ILikeMice/spymic/JOURNAL.md

# FYI, the time in brackets shows how time much i (roughly) spent on that session

## 06.08.26
### Initial research (~3h)

So, new project yaay, for this project i wanna make some sort of device i could stick onto walls (walls in question being doors/windows too maybe?) and listen to whatevers going on on the other side <br>
Disclaimer:: im making this thing for https://ispy.hackclub.com fyi, incase ts looks weirder than my other projects :p <br>
Overall this was inspired by some laser mic videos i saw online a couple years ago and me trying to listen to some oral test in a classroom before me through my phone, also a couple years ago!! (i would never now though)

I never really worked with mics and such, and defo not with laser mics or anything, so i was completely clueless as where to even start... <br>
My first thought was to replicate the same thing the people have done in the laser mic videos on youtube, mainly by shining a laser onto a window and it reflecting onto a solar cell, whereas the vibrations of the deflected laser would be picked up due to the laser not being completely on the solar cell and therefore the output would change in intensity when the surface vibrated. <br>
Some setups i looked into looked like this:
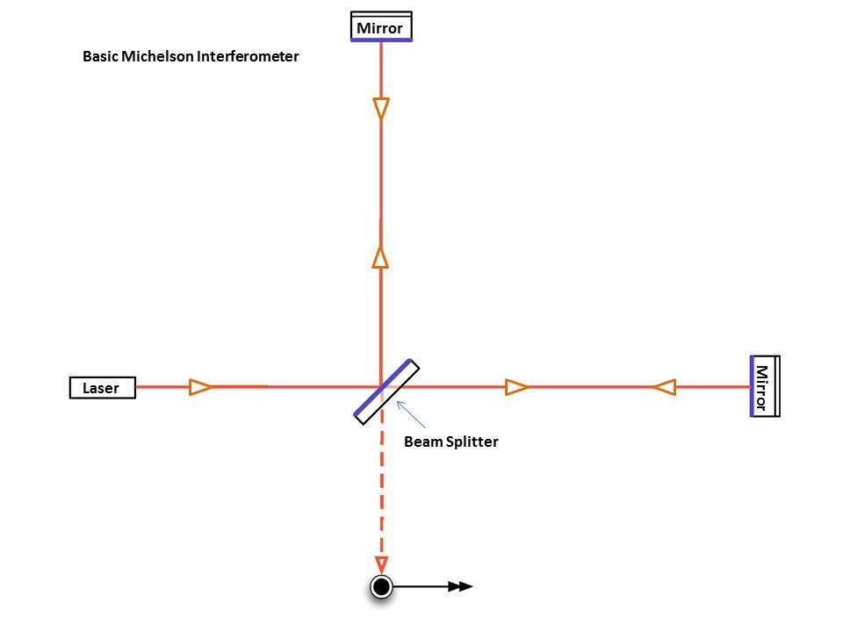
[picture p1: images/image-1.png]

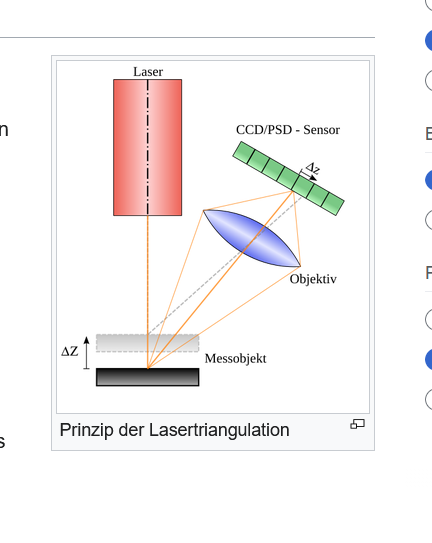
[picture p2: images/image-2.png]


Whereas i liked the first approach more tbh, but the 2nd one is cool too. The only problem(s) with this are though that <br>
1. if i attached the laser and the probe mirror as per the first approach (theres one control and one probe mirror, the probe mirror is on the vibrating surface) to the same surface, from the lasers POV there wouldnt be any sound or vibrations, so it wouldnt work at all.
2. the 2nd approach wouldnt really work either due to point 1. and the fact that im trying to attach this to a door, which MIGHT not be as reflective as a mirror/window, so were not getting any response on that either...

After the cool laser idea has been shattered, i decided to look into some other types of mics and found out about contact mics! They seem to be pretty cheap, and, after checking out some questionable vids about guys building them, i liked their quality enough and decided to use them!
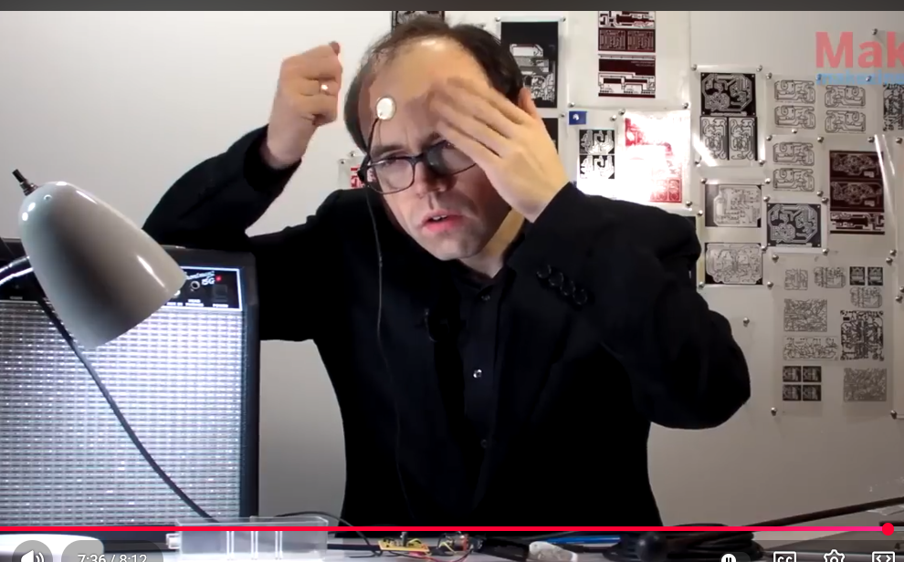
[picture p3: images/image-3.png]

shoutout this cool guy from 14 years ago on [youtube](https://www.youtube.com/watch?v=aOJuCYgmPPE) for demonstrating all that

Also started doing some research on components to use in the project, and got some example schematics to maybe use later on! Turns out piezo discs are real cheap, so i can make lots of these is the pcb and components are also cheap!! (for education purposes only)

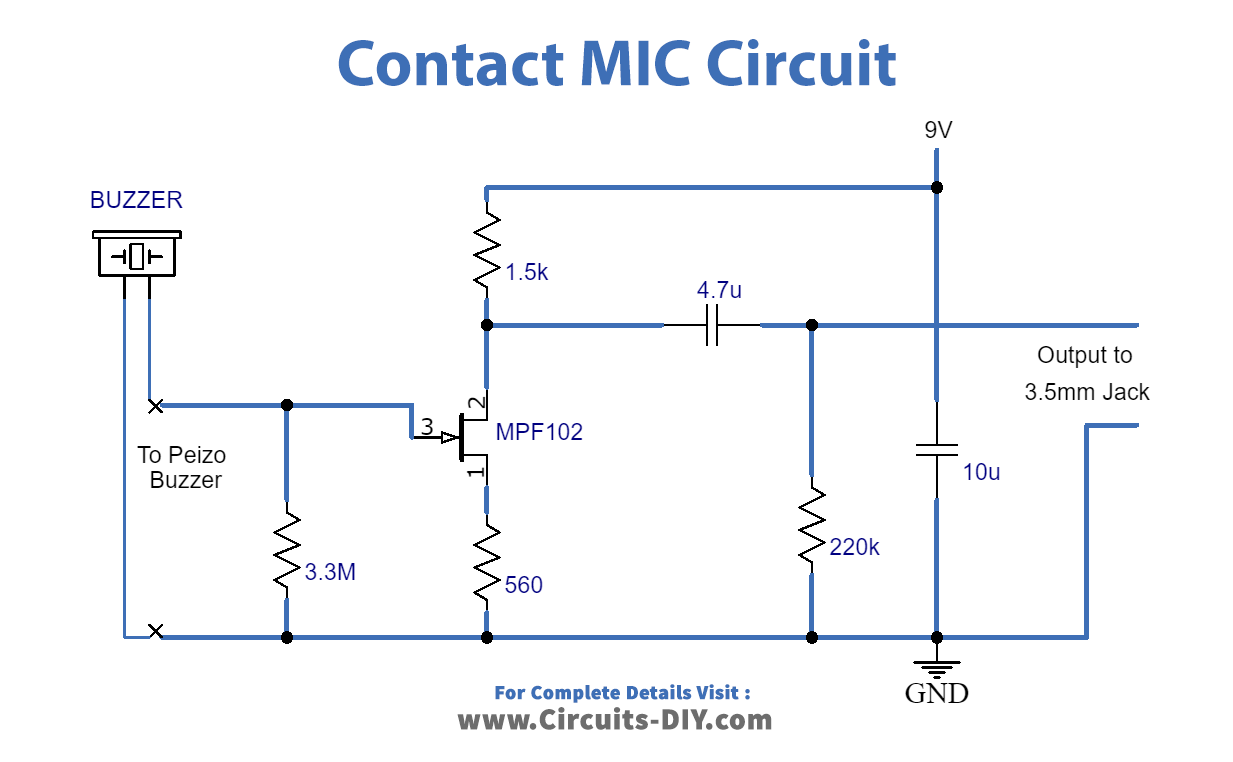
[picture p4: images/image.png]


Thats all for now, ive got some more features in mind that id love to add, but its about midnight here and id probably work on this tmrw!

## 08.08.26
### More research (~3.5h)

As the title suggests, i did some more research on this stuff. Mainly messed around in falstad though with the circuit but there was a fair share of researching done!!
<br>
So, at first i tried copying the circuit above into falstad, and after searching it up, i could replace the mic with an AC source in series with a capacitor with the capacitance of the mic.

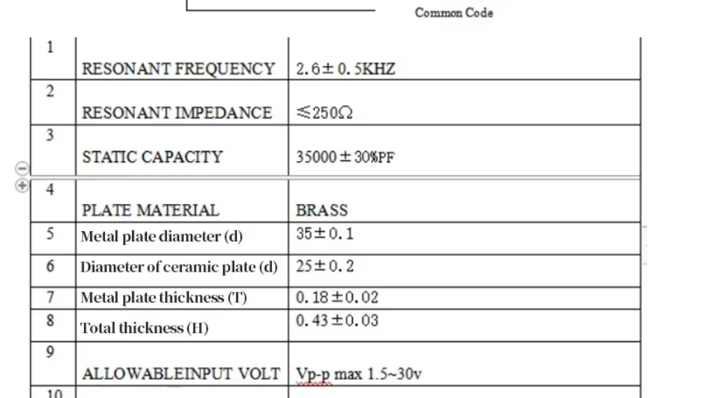
[picture p5: images/image-5.png]

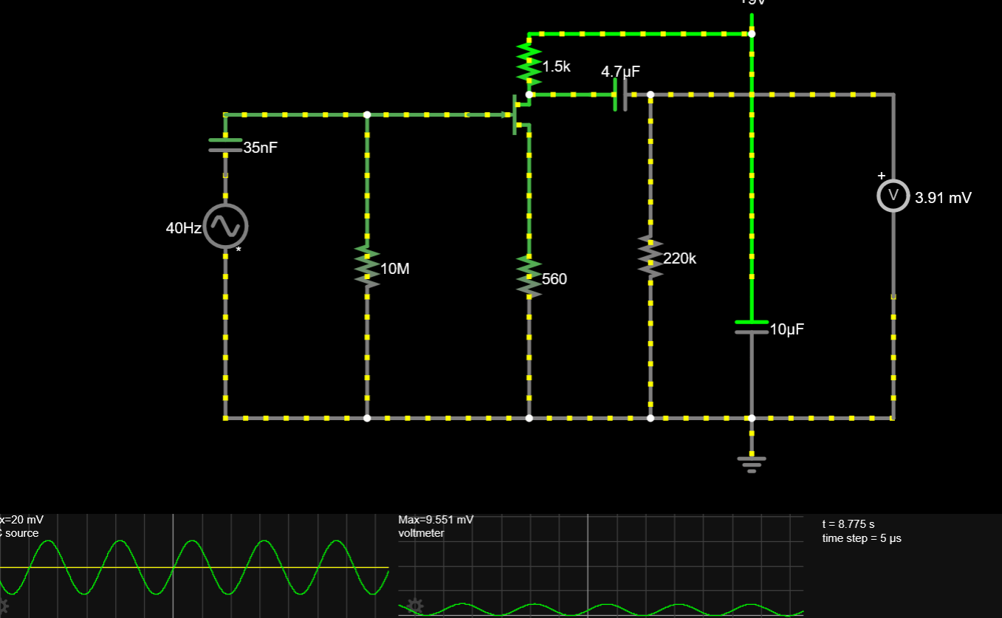
[picture p6: images/image-6.png]


<br>

For some reason, even after messing around with it for a while, that didnt work at all, so after looking some more stuff up and trying different configurations i just gave up, until i discovered opamps exist!! That seemed to be way easier and i had a circuit working almost directly!

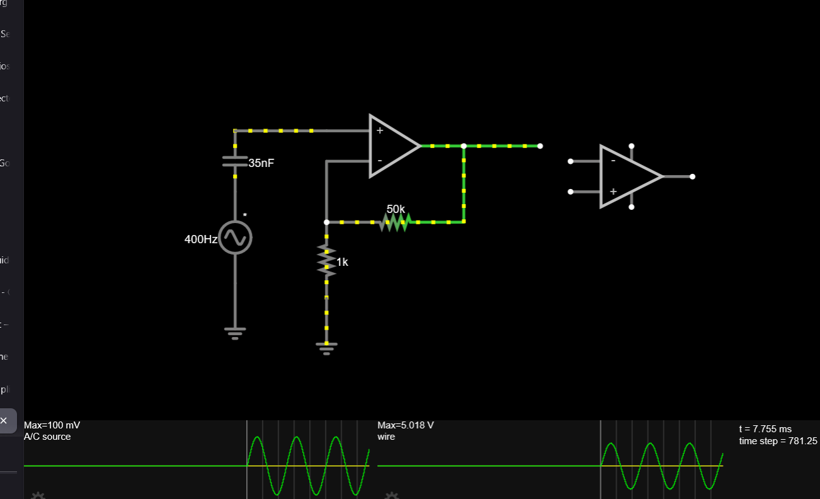
[picture p7: images/image-7.png]


<br> 
that was until i tried using a real opamp, which for some reason fucked everything up and just flatlined..

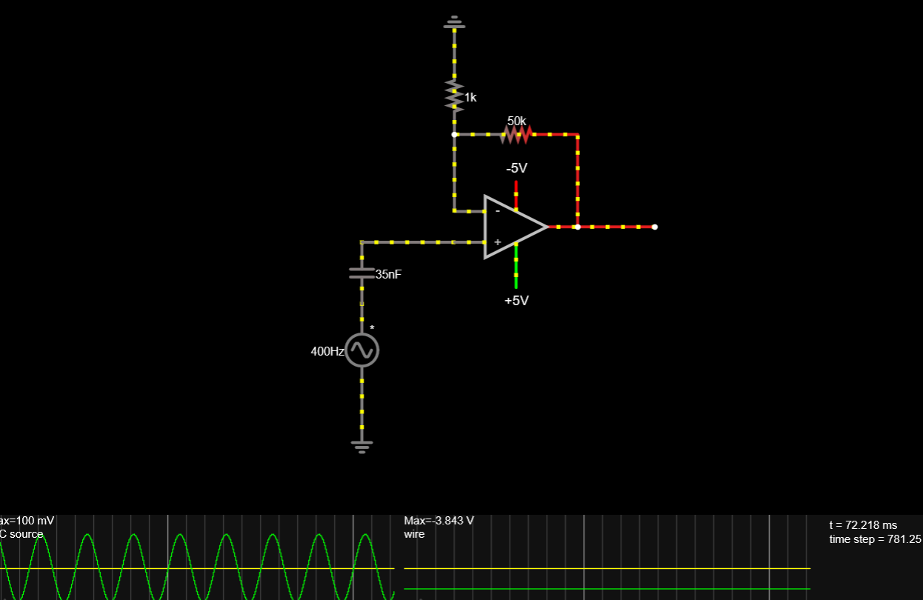
[picture p8: images/image-8.png]

<br>

the fix for the flatline was me being dumb and having the polarity of the opamp power reversed, and turns out i needed a pulldown resistor for the wave maximum to not go down slowly after that, for some reason i cant be bothered to understand, im just glad this shit finally works

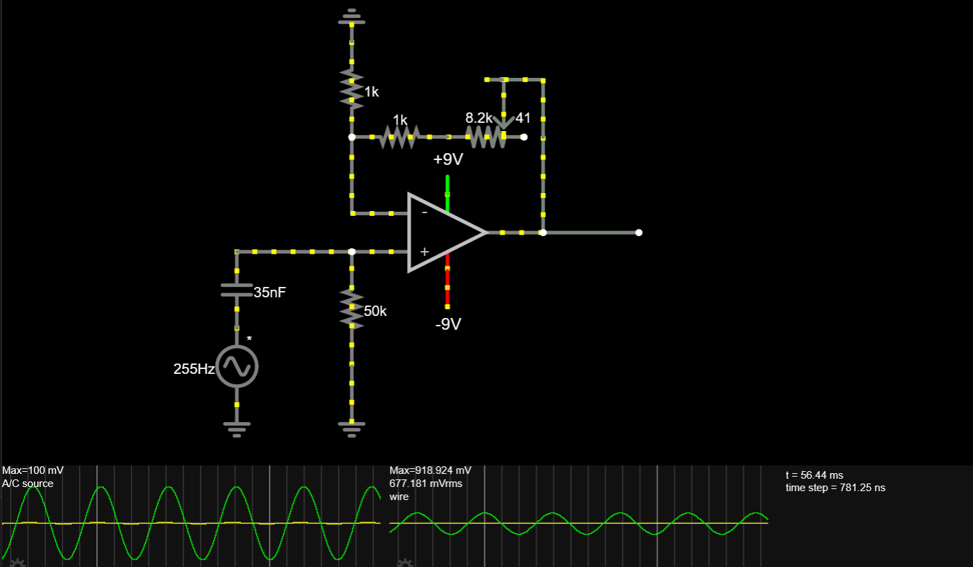
[picture p9: images/image-9.png]


Also started doing the schematic in kicad, but that took waayy longer than i thought, since i cant just feed 9v into the average opamp IC, so i had to look into buck converters after first finding an IC thats good enough and understanding what all the specs are

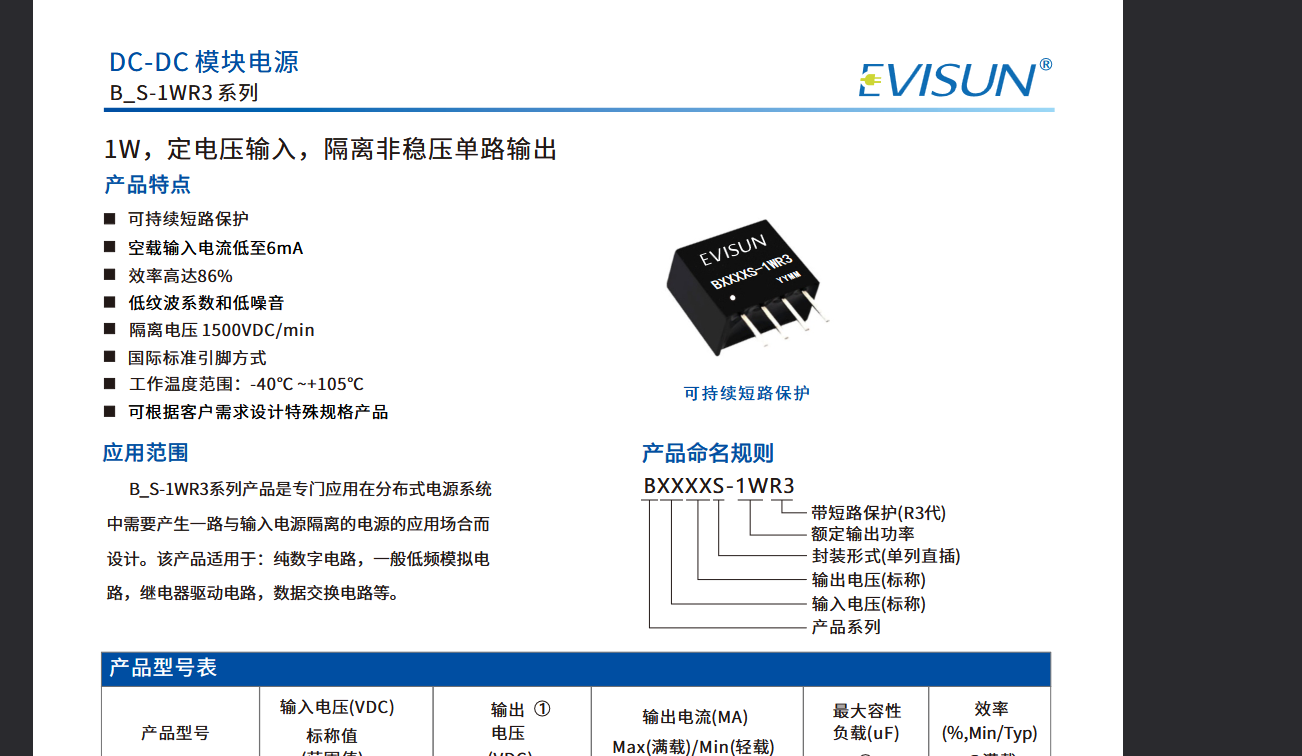
[picture p10: images/image-10.png]


didnt help much either that the datasheets for buck converters are ALL in chineese

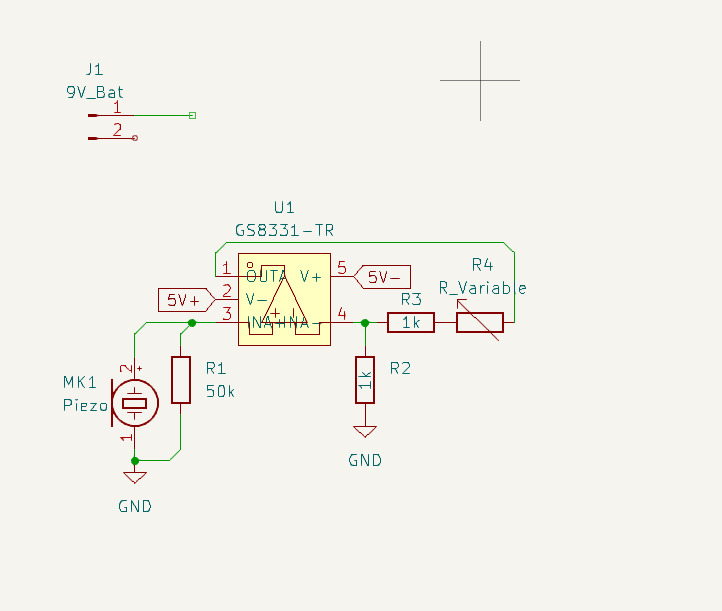
[picture p11: images/image-11.png]


## 09.08.26
### Component search (~2h)

So, now ive got the main amp thingy ready, but the only problem is that i cant just feed 9V into it, due to the opamps maximum ratings. I looked for a while on lcsc for some bigger opamps, but couldnt find one thatd fit me.. the 2nd option would be to have a stepdown with/without a LDO, i already started looking for buck converters yesterday, but the only one i found had a max power of just 1W, and i wasnt really sure if thatd be enough for me, besides, its output was 5v afaik, and to convert those to a clean 5V with an LDO i need a value higher than 5v, for example 6 or 6.5v

<br>

Only problem with other stepdowns is that they have only one, positive output, which also kinda fucks with the whole opamp circuit. I tried replacing the ground with a certain voltage so the wave would be somewhat offset, but i could only achieve that with an exact voltage of 3v, above which the wave would cut off on the top.

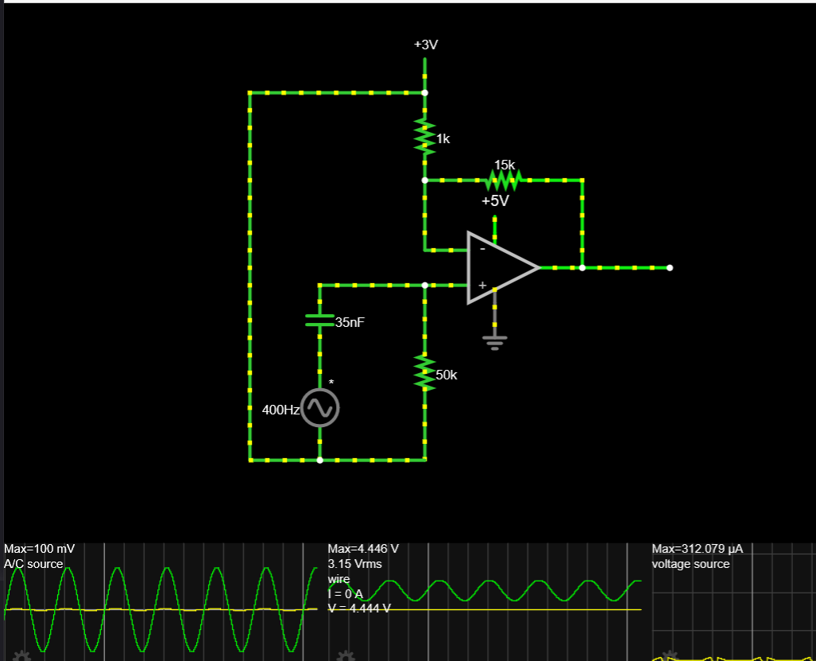
[picture p12: images/image-12.png]

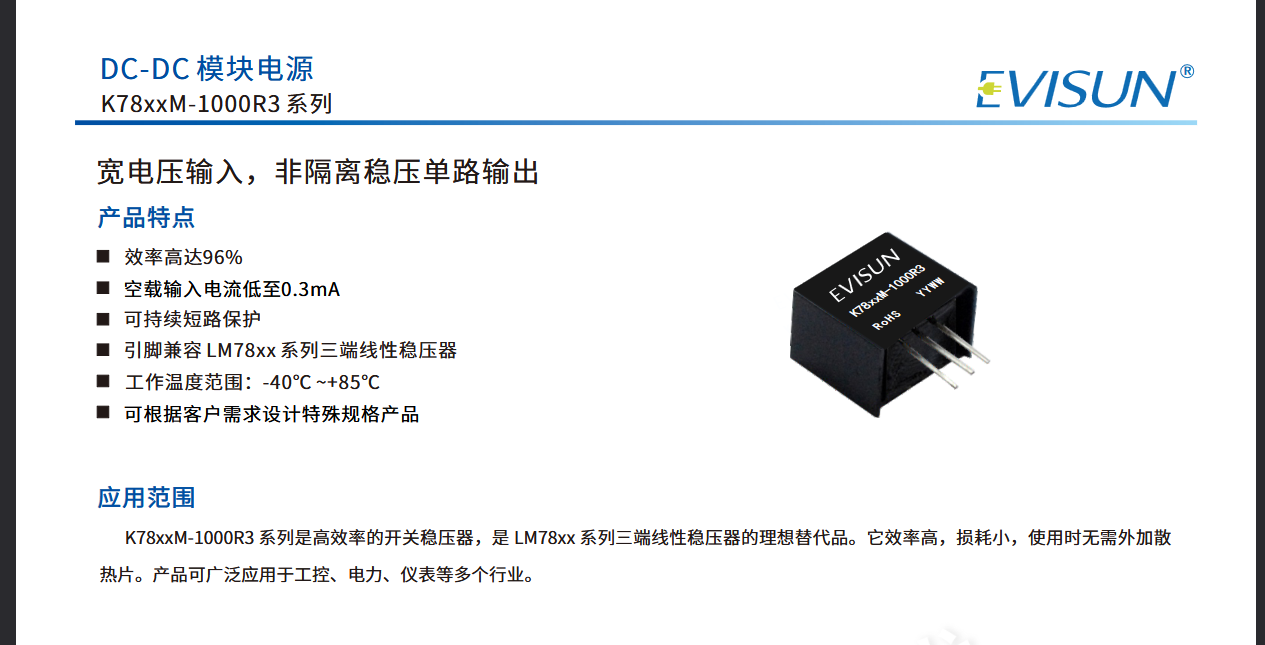
[picture p13: images/image-14.png]


since this approach sucks, i just looked into how i can invert a signal or something, but didnt really find a nice enough solution... while writing this journal though i stumbled upon the perfect buck converter, even though this one drops the voltage to 5v, but idgaf at this point and one single 1$ IC can give me both the negative and positive output i needed

### Power stuffs (~2h)

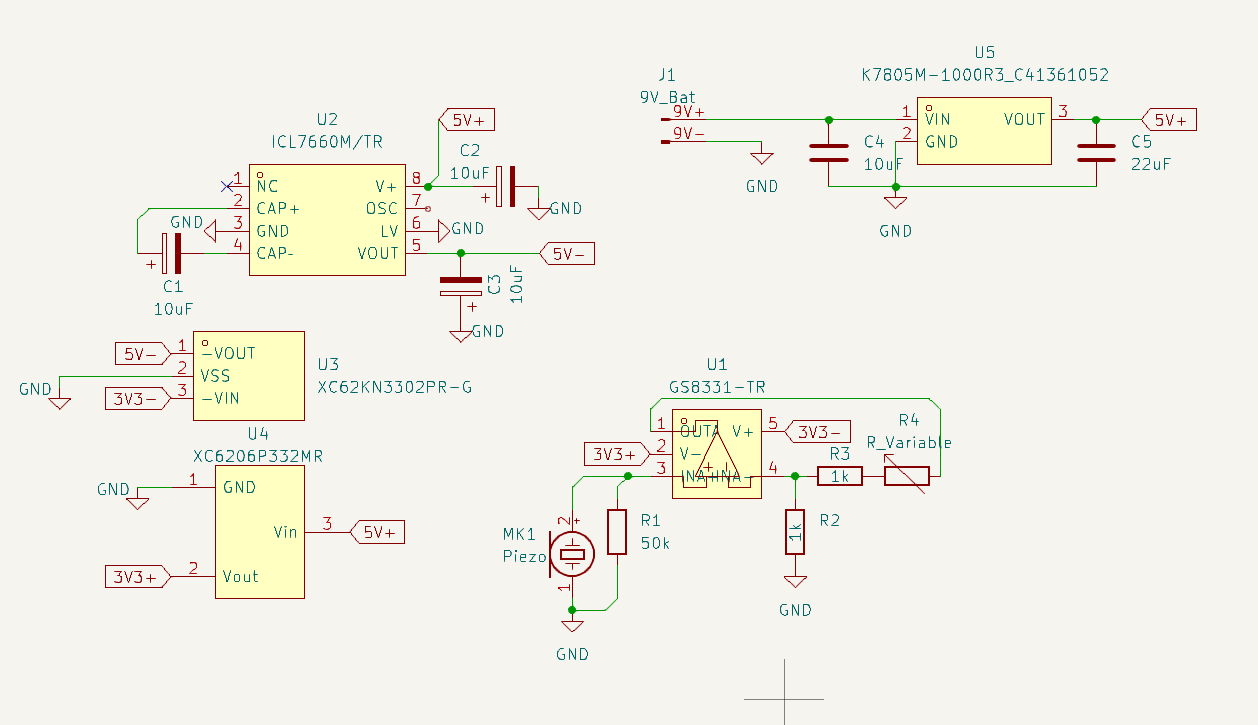
[picture p14: images/image-16.png]

So, forget whatever i said about the buck converter last journal, that IC could indeed not give both positive and negative outputs, sadly :/ after digging some more, i just decided to get an inverter for the negative signal. Didnt really wanna do this, but im hoping ill get a decently clean signal from both LDOs. Other than that, i think i should be almost fully done with the pcb part of this! just gotta add a potentiometer and headphone port, or add different output methods if i feel like it!!

## 15.08.26
### More power stuffs and hopefully finishing the PCB now (~1h)
Back again, been procrastinating this for a whiiiile because of some other stuff i had to finish before this.

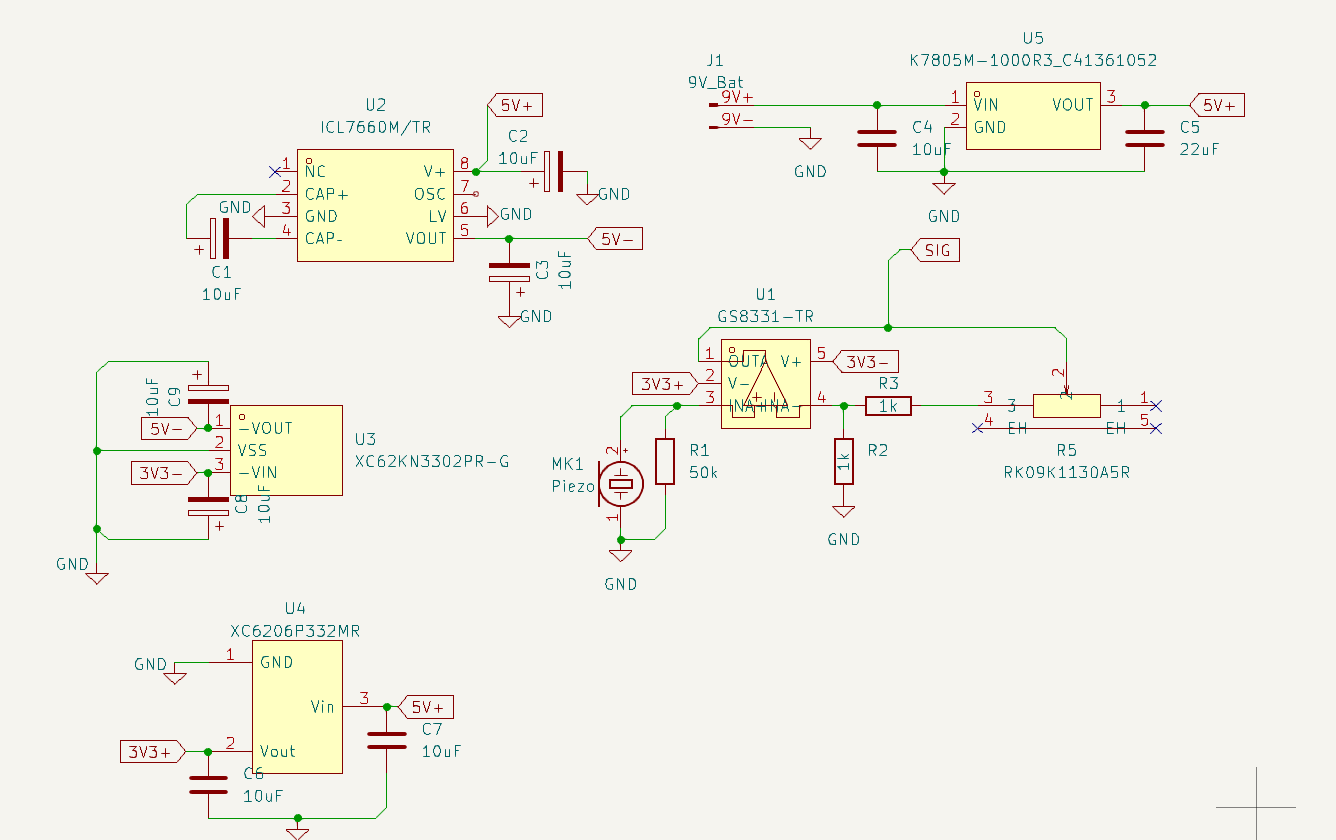
[picture p15: images/image-17.png]


all my components from my cart got voided when i made a new cart on lcsc, so i had to go find all of them again... while i was at it though i coincidentially checked the datasheets just one more time and noticed i fucked up the wiring on some of the components and i was missing some capacitors here and there. After fixing that and going through all components one more time, i added the variable resistor to my schematic! Pretty sure this should hopefully be all for now, all im missing is the signal part of the output.

## 16.08.26
### Volume control redesign & possibly digital outputs? (~2.5h)

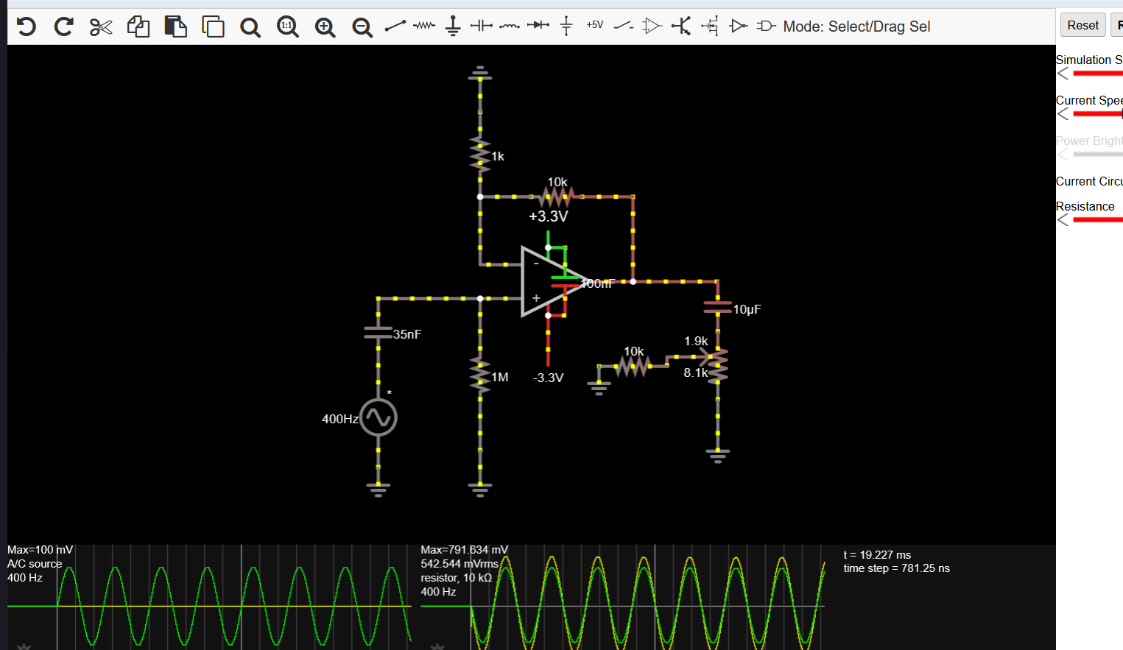
[picture p16: images/image-18.png]


Apparently the way i was doing volume control was the wrong way, and i shouldnt mess with the gain itself since that behaves kinda goofy when i adjust it, e.g. the output drifts to be biased at voltages lower than 0 and cuts off if it drifts down too low.
This seems to fix it, and works decently well!

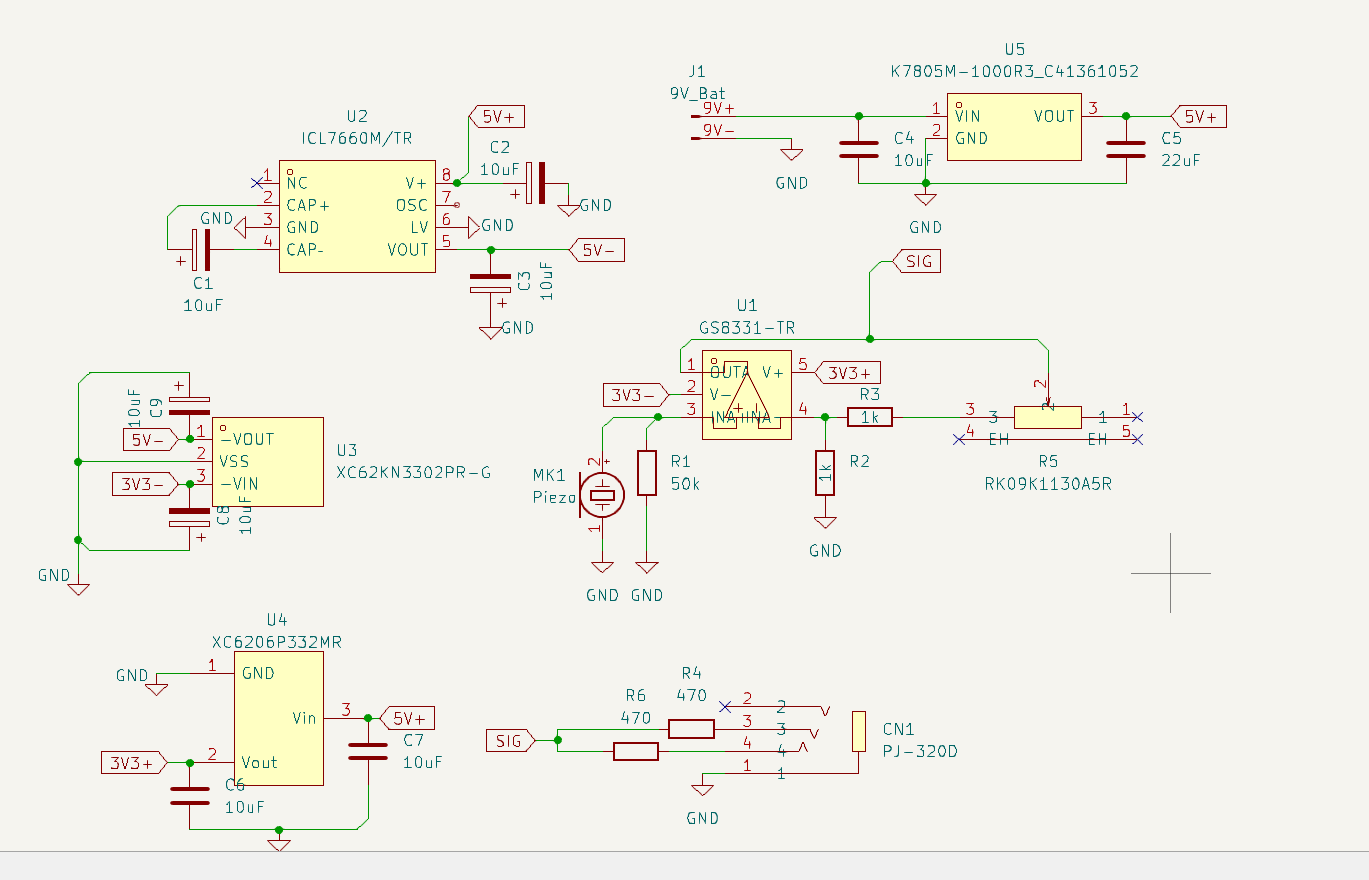
[picture p17: images/image-19.png]


I updated the schematic with a potentiometer i found on lcsc, and added a headphone jack output, once again i got confused by the wiring for that for a bit, shits mad weird but i think i got it.
This seemed to be cool enough, but i felt like for a spy device being limited by the headphone cable would be not as cool, since just standing infront of a door to listen seems kinda lame, might aswell press your ear to it and get potentially better results.

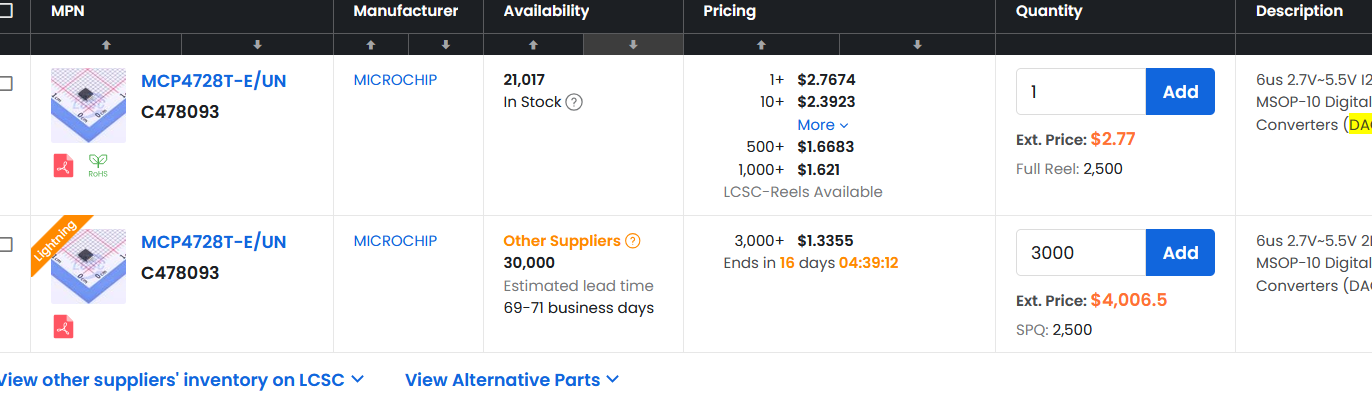
[picture p18: images/image-20.png]


Thatd require some sort of ADC and a bluetooth transmitter, meaning i need some main controller probably and get that to output stuff in realtime to a blueotooth device. Maybe a transistor or something to switch analog/digital output?

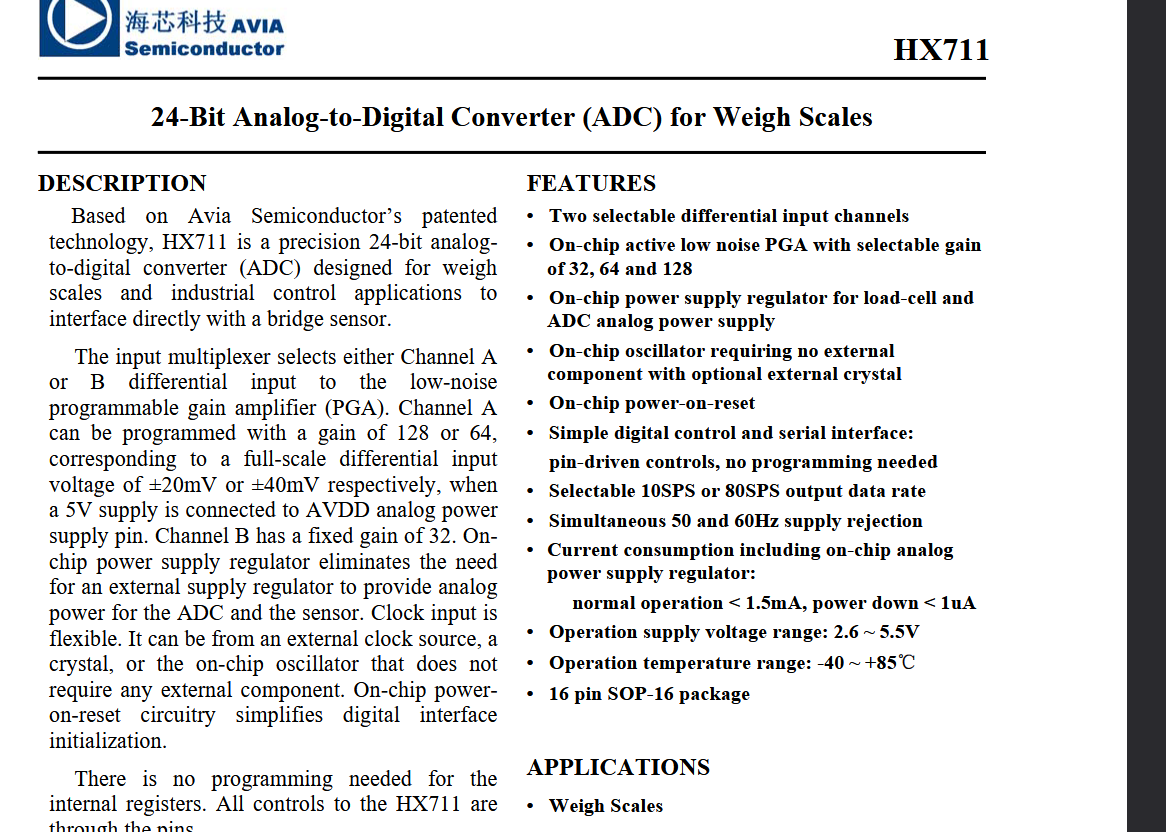
[picture p19: images/image-21.png]


I found a really good ADC, 24bits of resolution for only 50 cents! Started reading the documentation and contemplating on how to integrate  all this, until i realized that this one had a ~50hz output limit meaning i cant do shit with it :/

## 17.08.26
### Minor fixes (~0.5h)

Went over the whole thing again and fixed some missing capacitors/wrong netlabels on the schematic. Also, turns out my opamp only goes up to 2.7V with a dual power supply, so i went and found a cheap one for roughly the same price that supports higher voltages!

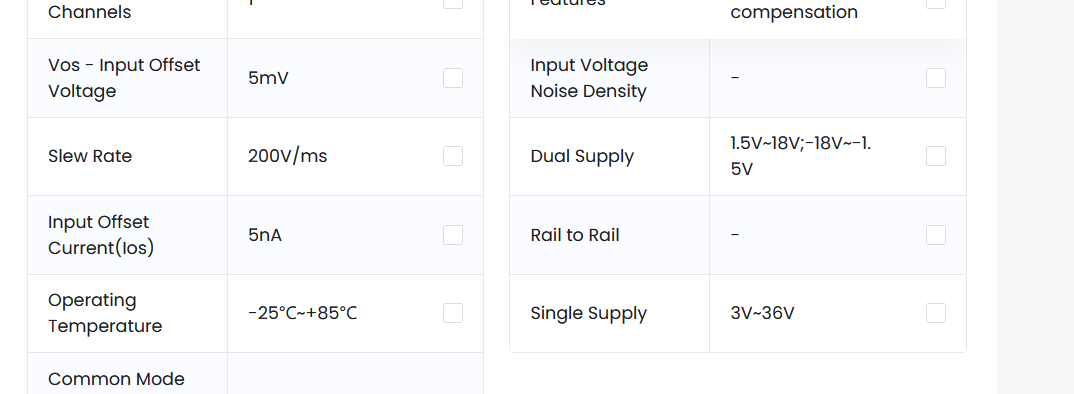
[picture p20: images/image-22.png]


## 21.08.26

### Schematic improvements (~1h)

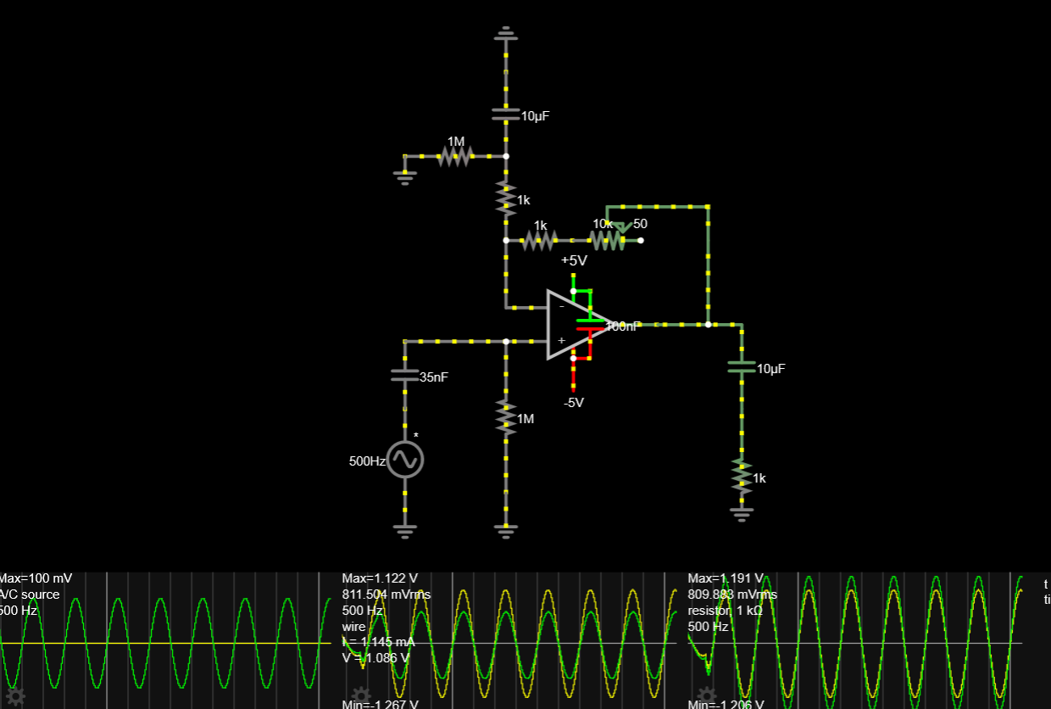
[picture p21: images/image-23.png]


The volume adjustment circuit i used so far couldnt really give me more than ~700 or so mVrms output, and apparently you need a bit more than that for louder volumes on normal 32ohm headphones. 
Only problem is that just increasing the gain on the opamp would cause it to drift some more, and with a higher amplitude it would just clip around 2.something volts, giving me an unuseable output. After some research, i found out i can add a capacitor and large resistor to reduce the voltage bias drifting down.

One potentiometer wasnt really enough though, so i added a second one like so:

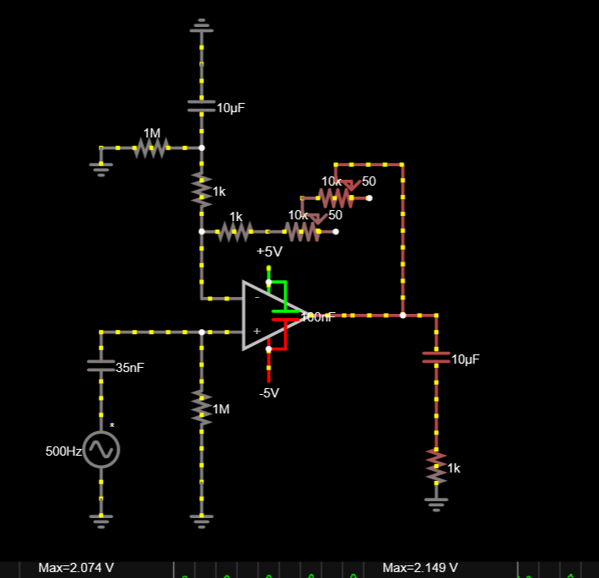
[picture p22: images/image-24.png]


## Footprint assignment and Routing! (~2.5h)

So, im pretty sure the schematic is almost done now, im not gonna bother with bluetooth output since thats above my current level right now, and the deadline got shortened so i dont have too much time to finish this either. Before i started routing though i needed to go thru the whole thing and find some footprint for every single other component that was left. 

That went by faster than i thought and i could finally start working on the layout!!

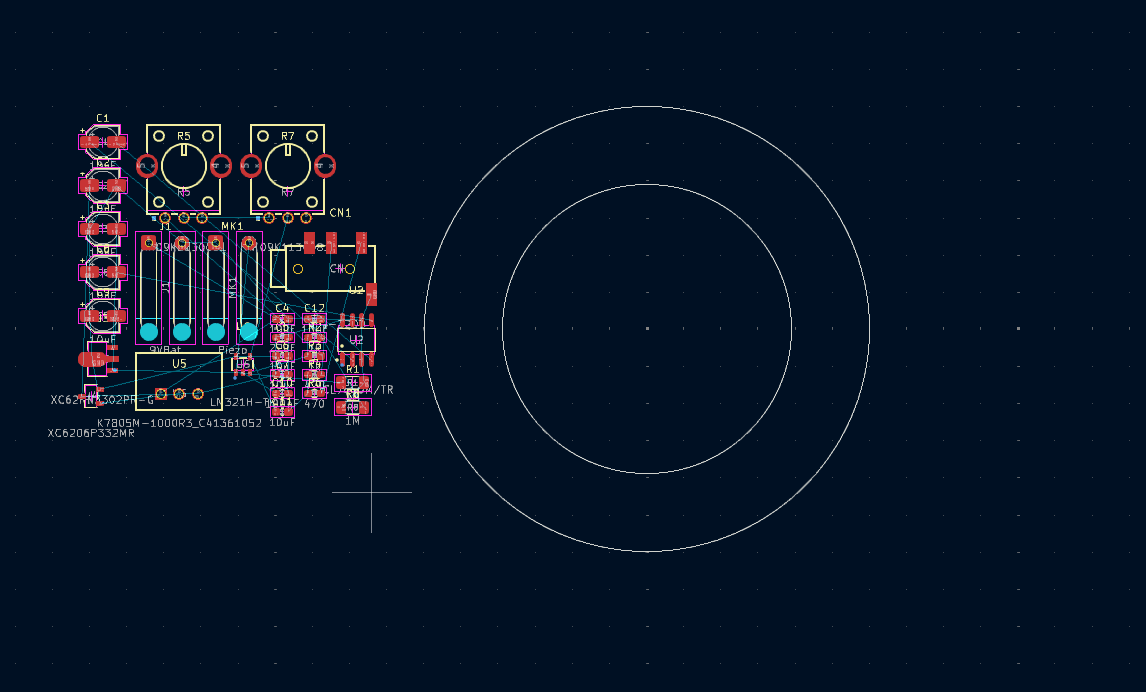
[picture p23: images/image-25.png]


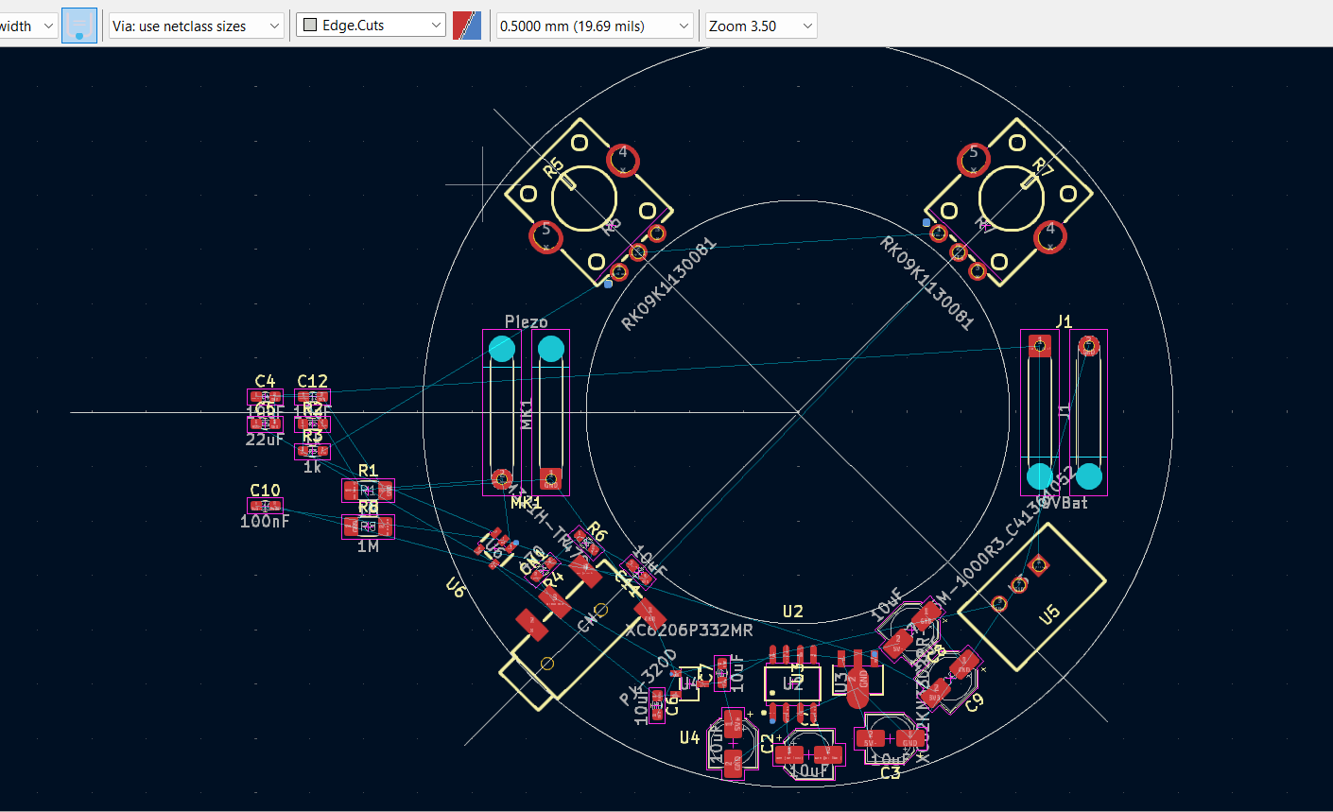
[picture p24: images/image-26.png]


The first layout idea had both potentiometers at the top, with the headphone jack at the bottom. I really liked this design, but i remembered some video i watched a while ago on piezo mics (and i think this goes for mics overall, but wtvr), where the guy explained how to minimize noise from passing radio waves, etc etc.. Main point is that the wires from the piezo acted as tiny antennas, and i presume traces most likely will too, so my goal here was to minimize the overall trace length.

either way, i started by organizing power, etc. at the bottom and tried clumping it all together. Idea here was to have a path that goes from the battery to the output, without too many back and forths of the signal and without long lines.

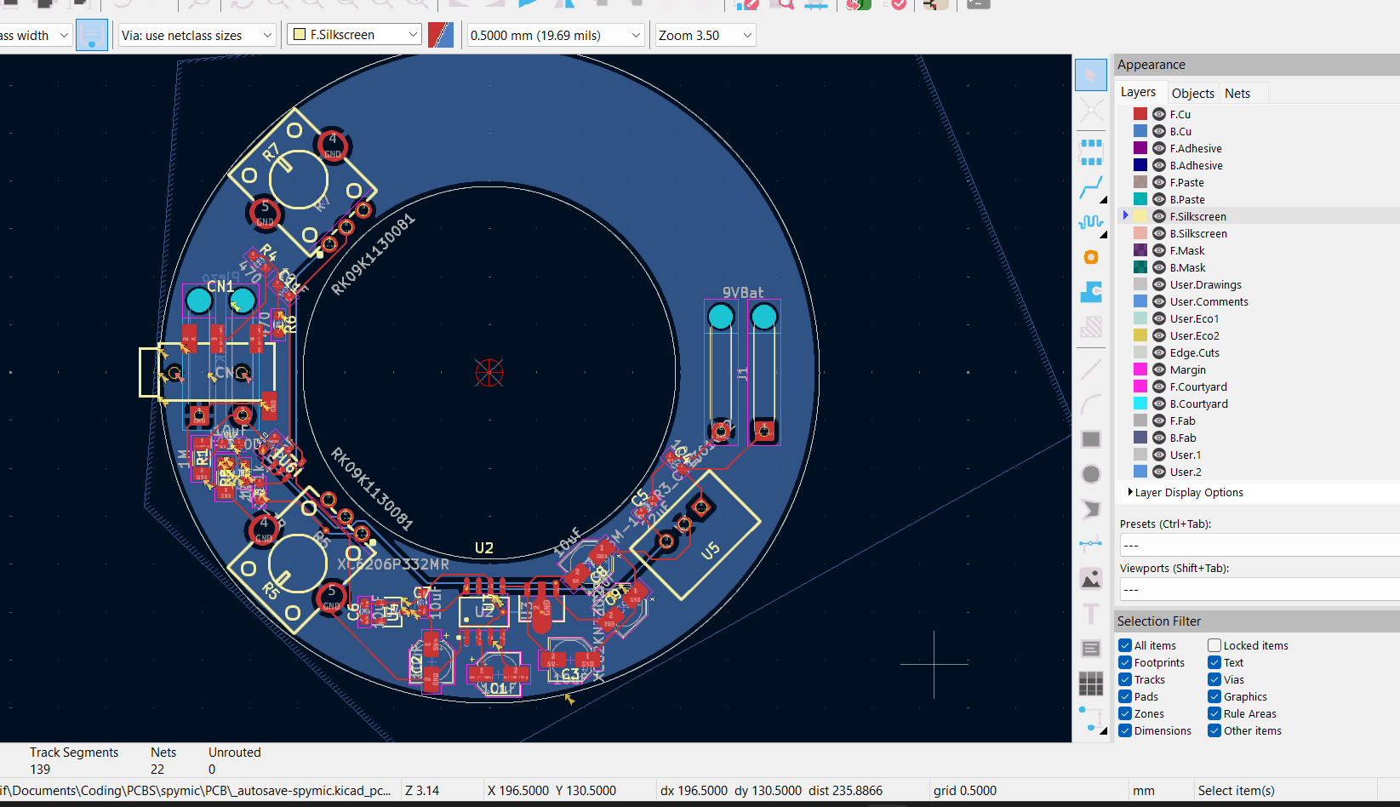
[picture p25: images/image-27.png]


Final version ended up looking something like this, although i first routed a version with the piezo holes at the top, and later realized that the bottom of the PCB still had a ton of space for the wire, so i moved it below the headphone jack to save some really long traces and space overall.

### PCBA! (~1h)
So, PCB was done, all im concerned about now are the costs to make ts. The components alone had an extra tax of ilke 13 bucks and ended up costing roughly 40usd for 20$ worth of components.

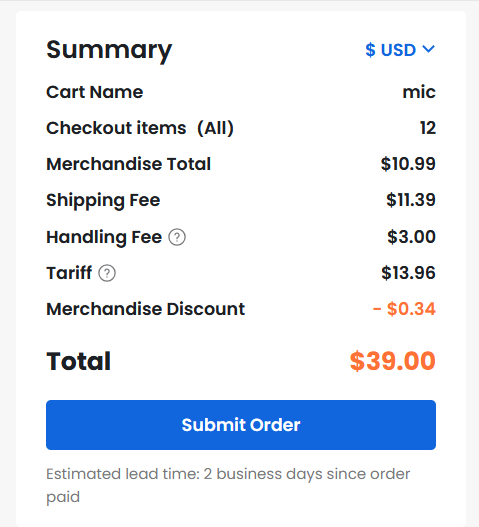
[picture p26: images/image-28.png]


I decided to try PCBA for the first time ever, since im pretty sure that its sometimes cheaper. After doing all the setup needed and exporting all the stuff, i still had to go thru all the components again, since most of them were extended parts costing me like 20 extra dollars. in the process i had to remove the electrolytic caps and potentiometers, since jlc was ordering wayyyy too many of either and both of them were extended parts. luckily though, my local electronics store has almost identical potentiometers and exactly the same caps, even though theyre a bit more expensive, but whatever, still cheaper in the end to buy them here.

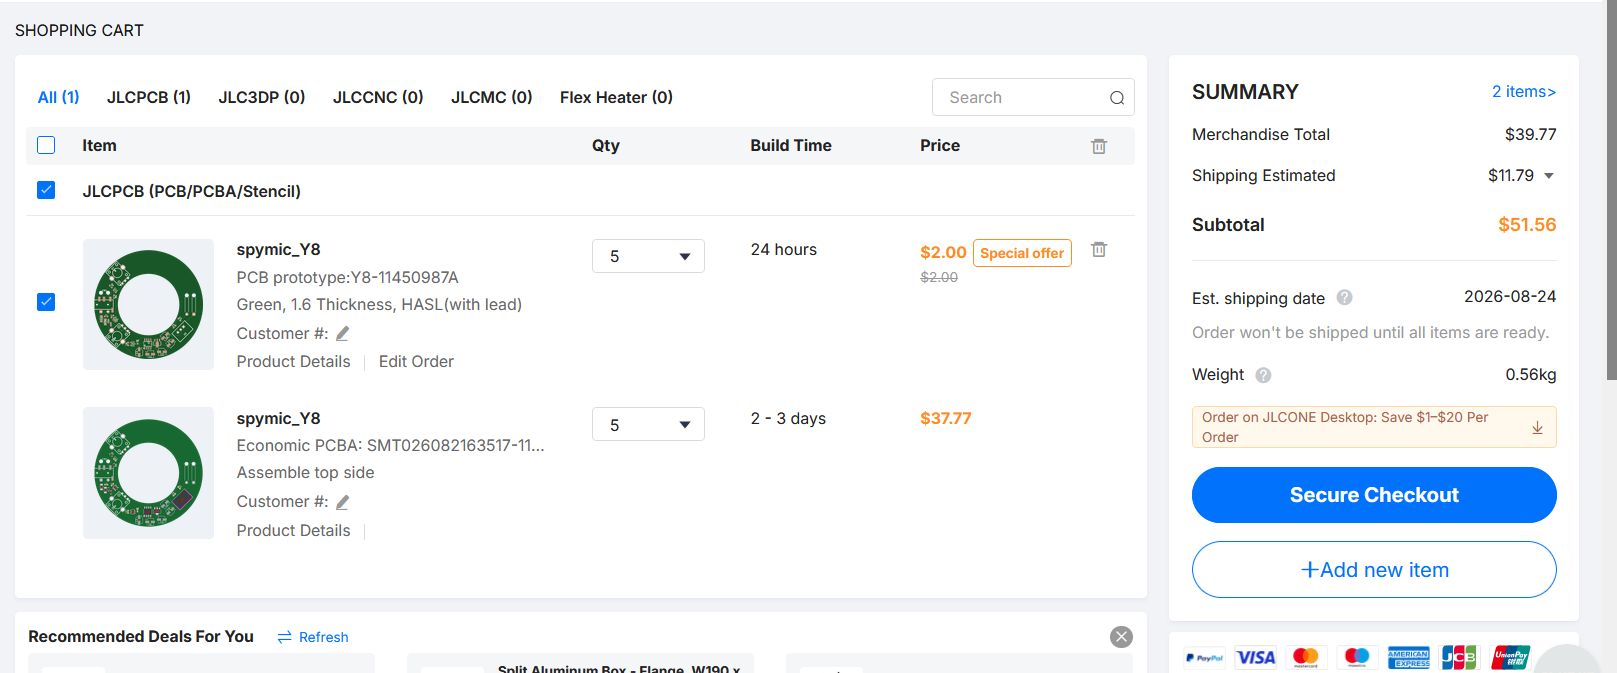
[picture p27: images/image-29.png]


final price for 5 PCBAs was 51$, roughly 10$ difference if i were to order 2 PCBAs cause most of the components have an MOQ of 20 or so.

Actually, just checked and the grand total for 5 pcbas is 70usd, with 20$ of taxes holy shit this thing is expensive, yikes.

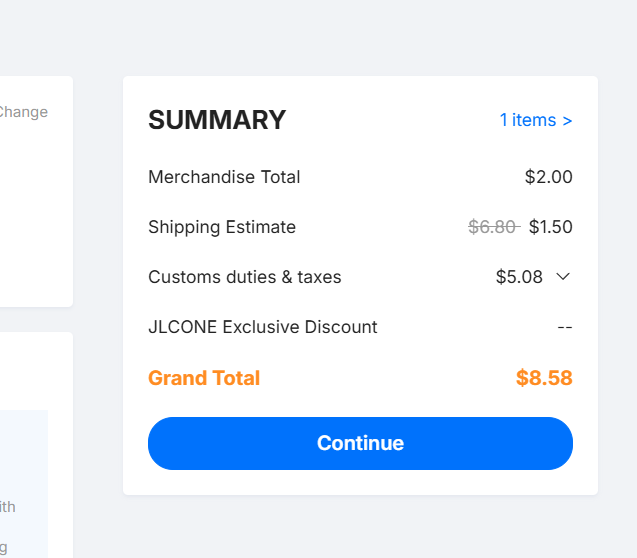
[picture p28: images/image-30.png]


Checked the price for the pcb alone and it turned out to under 10 bucks total, on a new account, so we might be up actually for a total of 50 bucks! I was gonna talk about how i wanted to redesign this whole thing with basic components only, but i guess were not doing that!

## 22.08.26
