ILikeMice/spymic/images/image-13.png

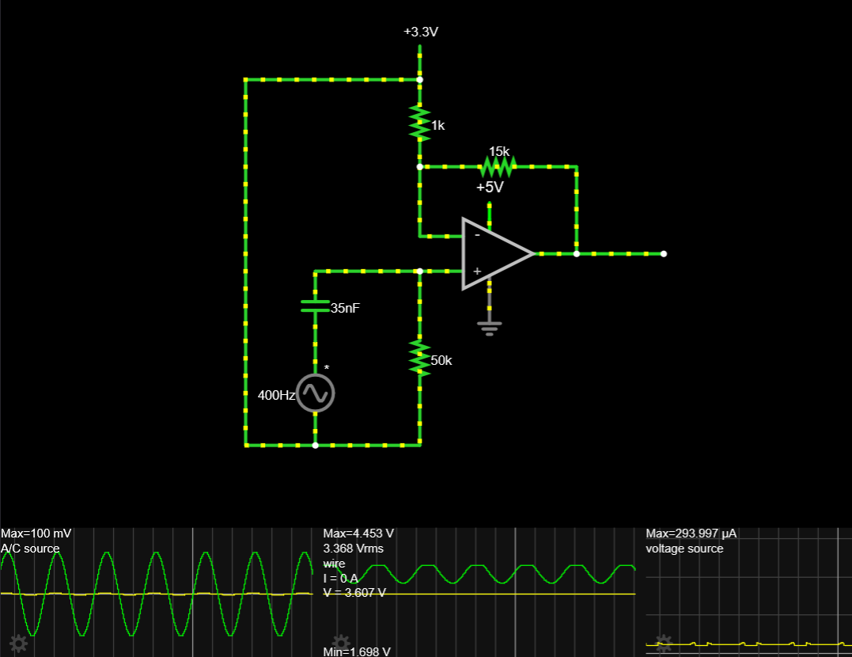
images/image-13.png
