ILikeMice/spymic/PCB/spymic.kicad_pcb

## KiCad design PCB/spymic.kicad_pcb (2026-08-22)

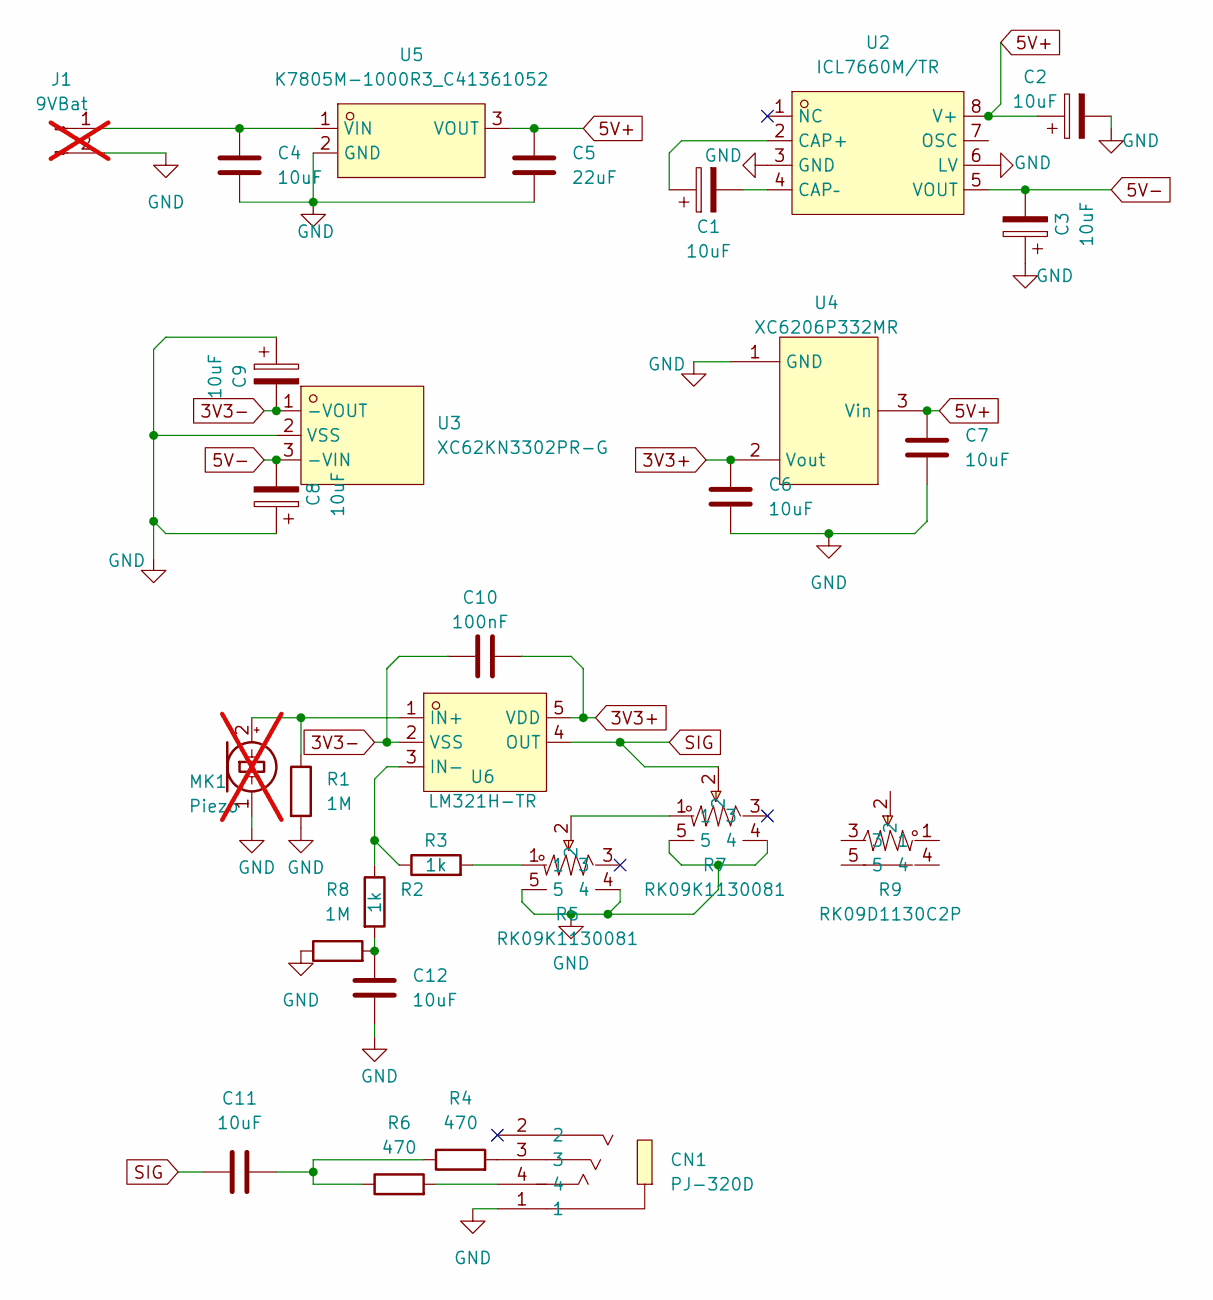
[picture p30: schematic spymic.kicad_sch]

Parts:
C1, C2, C3, C8, C9: 10uF; CP_Elec_4x5.4; LCSC Part C72485
C4, C6, C7, C11, C12: 10uF; C_0603_1608Metric_Pad1.08x0.95mm_HandSolder; LCSC Part C1691
C5: 22uF; C_0603_1608Metric_Pad1.08x0.95mm_HandSolder; LCSC Part C59461
C10: 100nF; C_0603_1608Metric_Pad1.08x0.95mm_HandSolder; LCSC Part C59461
CN1: PJ-320D; AUDIO-SMD_PJ-320D-1; LCSC Part C431535
J1: 9VBat; SolderWire-0.25sqmm_1x02_P4.5mm_D0.65mm_OD2mm_Relief; not fitted
MK1: Piezo; SolderWire-0.25sqmm_1x02_P4.5mm_D0.65mm_OD2mm_Relief; not fitted
R1, R8: 1M; R_1206_3216Metric_Pad1.30x1.75mm_HandSolder; LCSC Part C17927
R2, R3: 1k; R_0603_1608Metric_Pad0.98x0.95mm_HandSolder; LCSC Part C2907002
R4, R6: 470; R_0603_1608Metric_Pad0.98x0.95mm_HandSolder; LCSC Part C23179
R5, R7: RK09K1130081; RES-TH_RK09K1130AAU; MPN RK09K1130081; LCSC Part C470311
R9: RK09D1130C2P; RES-TH_RK09D1130C2P; MPN RK09D1130C2P; LCSC Part C361173
U2: ICL7660M/TR; SOP-8_L4.9-W3.9-P1.27-LS6.0-BL; MPN ICL7660M/TR; LCSC Part C356724
U3: XC62KN3302PR-G; SOT-89-3_L4.5-W2.5-P1.50-LS4.2-BR; MPN XC62KN3302PR-G; LCSC Part C165901
U4: XC6206P332MR; SOT-23-3_L2.9-W1.6-P1.90-LS2.8-BR; MPN XC6206P332MR-G; LCSC Part C5446
U5: K7805M-1000R3_C41361052; PWRM-TH_DEXU_K780XM-1000R3; MPN K7805M-1000R3; LCSC Part C41361052
U6: LM321H-TR; SOT-23-5_L2.9-W1.6-P0.95-LS2.8-BL; MPN LM321H-TR; LCSC Part C2927688

Connections:
3V3+: C6.1, C10.2, U4.2 (Vout), U6.5 (VDD)
3V3-: C9.2, C10.1, U3.1 (-VOUT), U6.2 (VSS)
5V+: C2.1, C5.1, C7.1, U2.8 (V+), U4.3 (Vin), U5.3 (VOUT)
5V-: C3.2, C8.2, U2.5 (VOUT), U3.3 (-VIN)
GND: C2.2, C3.1, C4.2, C5.2, C6.2, C7.2, C8.1, C9.1, C12.2, CN1.1, J1.2, MK1.1 (-), R1.2, R5.4, R5.5, R7.4, R7.5, R8.1, U2.3 (GND), U2.6 (LV), U3.2 (VSS), U4.1 (GND), U5.2 (GND)
unnamed: C11.2, R4.1, R6.1
unnamed: C12.1, R2.2, R8.2
unnamed: CN1.3, R4.2
unnamed: CN1.4, R6.2
unnamed: C4.1, J1.1, U5.1 (VIN)
unnamed: MK1.2 (+), R1.1, U6.1 (IN+)
unnamed: R3.2, R5.1
unnamed: R5.2, R7.1
unnamed: C1.1, U2.2 (CAP+)
unnamed: C1.2, U2.4 (CAP–)
unnamed: R2.1, R3.1, U6.3 (IN-)
SIG: C11.1, R7.2, U6.4 (OUT)

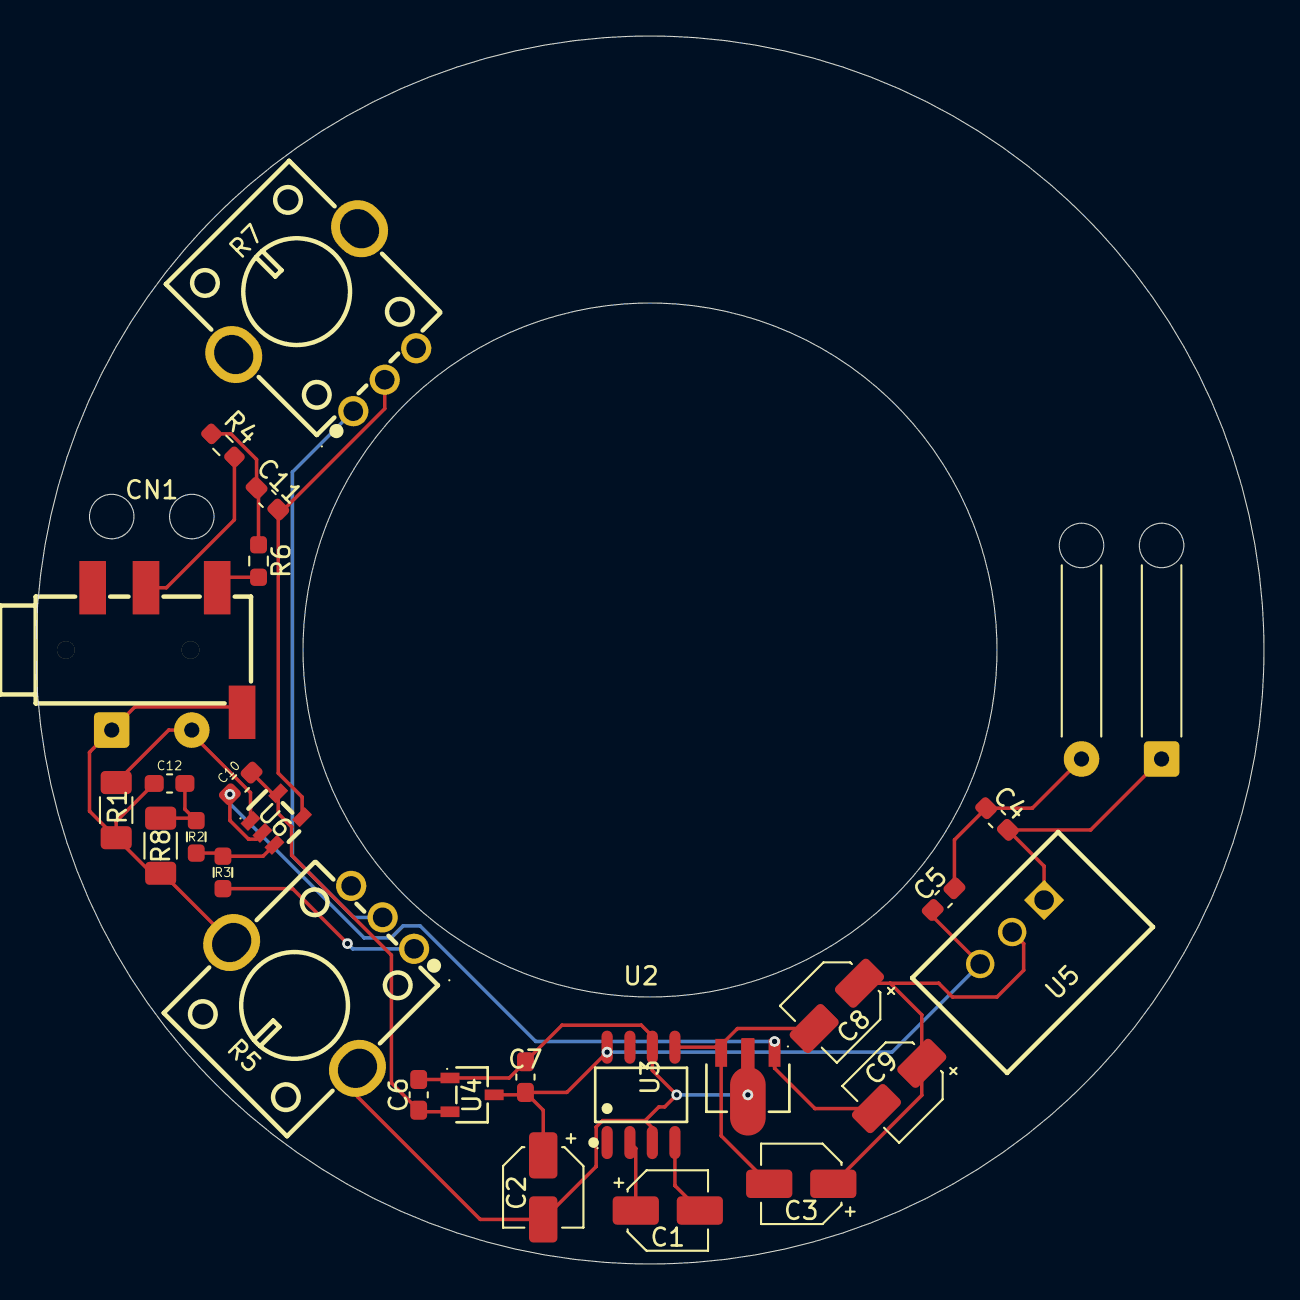
[picture p31: board spymic.kicad_pcb from above]

Board: 2 copper layers, 69.0 x 69.0 mm, 28 parts (1 on the bottom side), 17 nets.
