ILikeMice/spymic/(commit log)

2026-08-16 c ommit
    [spymic.kicad_sch]
2026-08-22 huge journal backlog
    [bom.csv, designators.csv, positions.csv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]
